UCSD-Quadcopter-Class/quad-hardware-yolo/design_reviews/questions_about_our_board.txt

Meeting Location: NVSL (CSE 2209)
Meeting Time: May 3rd, 7:00pm

 - The vias should go all the way around all the antenna components
