UCSD-Quadcopter-Class/quad-hardware-yolo/quadcopter.dxf

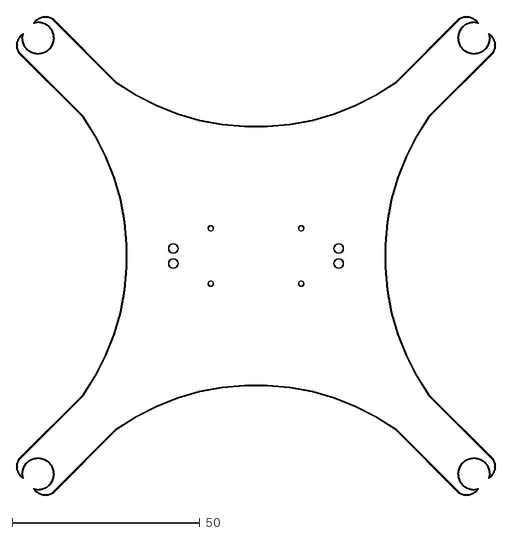
[picture p1: CAD file, 2017-05-15]
quadcopter.dxf
127.6 x 127.6
