UCSD-Quadcopter-Class/quad-hardware-yolo/quadcopter.brd

## EAGLE design quadcopter.brd (2017-05-15)

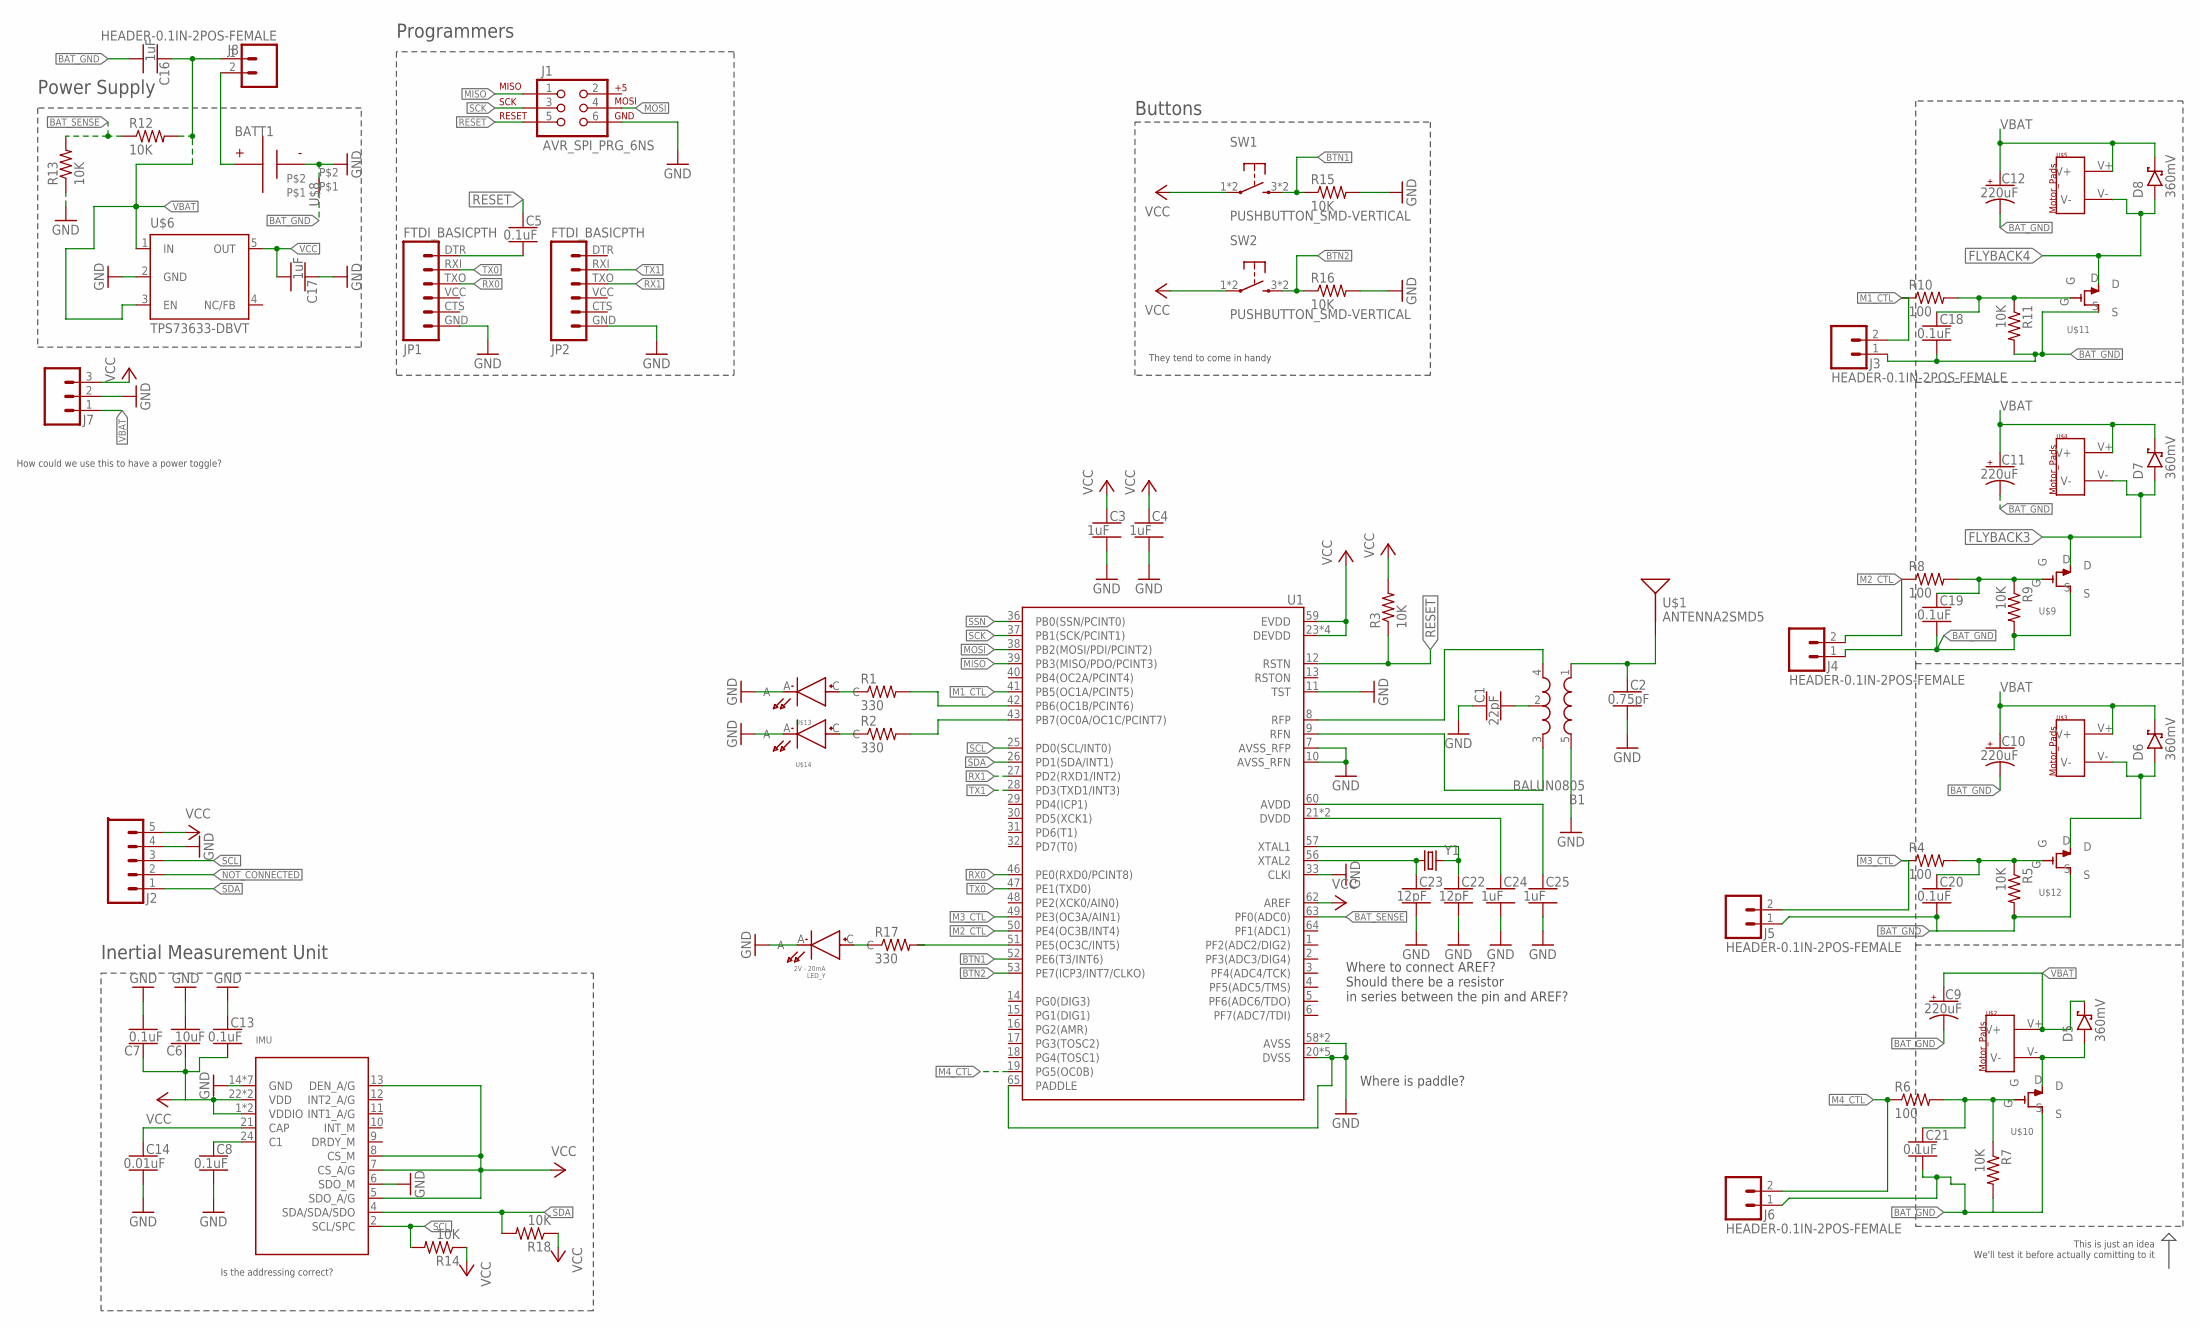
[picture p2: schematic quadcopter.sch]

Parts:
B1: BALUN0805; BALUN
BATT1: BATTERY-HUBSAN-W/HOLDER; BATTERY-W/HOLDER-380MAH-HUBSAN
C1: 22pF; CAPC2012X140_HS
C2: 0.75pF; CAPC2012X140_HS
C3, C4, C16, C17, C24, C25: 1uF; CAPC2012X140_HS
C5, C7, C8, C13, C18, C19, C20, C21: 0.1uF; CAPC2012X140_HS
C6: 10uF; CAPC2012X140_HS
C9, C10, C11, C12: 220uF; CAPMP7343X310_HS
C14: 0.01uF; CAPC2012X140_HS
C22, C23: 12pF; CAPC2012X140_HS
D5, D6, D7, D8: 360mV; SOD3716X135_HS
IMU: IMU; IMU_LSM9DS1TR
J1: AVR_SPI_PRG_6NS; 2X3-NS
J2: HEADER-0.1IN-5POS-FEMALE; HDRV5W63P254_5X1_1270X254H838_HS
J3, J4, J5, J6, J8: HEADER-0.1IN-2POS-FEMALE; HDRV2W63P254_2X1_508X254H838_HS
J7: HEADER-0.1IN-3POS-MALE; HDRV3W63P254_3X1_762X254H838_HS
JP1, JP2: FTDI_BASICPTH; FTDI_BASIC
LED_Y: 2V - 20mA; LED_LTST-C170EKT
R1, R2, R17: 330; RESC2012X60_HS
R3, R5, R7, R9, R11, R12, R13, R14, R15, R16, R18: 10K; RESC2012X60_HS
R4, R6, R8, R10: 100; RESC2012X60_HS
SW1, SW2: PUSHBUTTON_SMD-VERTICAL; TE_FSM8JSMA_HS
U1: ATMEGA128RFA1; QFN-64
U$1: ANTENNA2SMD5; ANTENNA-CHIP5
U$2, U$3, U$4, U$5: MOTOR_PADS
U$6: TPS73633-DBVT; SOT23-DBV
U$8: NET_BRIDGE
U$9, U$10, U$11, U$12: N-FET; N_FET_SI2302CDS-T1-E3CT-ND
U$13, U$14: LED-RED; LED_LTST-C170EKT
Y1: CRYSTAL5X3; CRYSTAL-SMD-5X3

Connections:
ATTENNA: B1.1 (IN), C2.1, U$1.FEED
BAT_GND: C9.2 (-), C10.2 (-), C11.2 (-), C12.2 (-), C16.2, C18.2, C19.2, C20.2, C21.2, J3.1, J4.1, J5.1, J6.1, R5.2, R7.2, R9.2, R11.2, U$8.P$1, U$9.S, U$10.S, U$11.S, U$12.S
BAT_SENSE: R12.1, R13.2, U1.63 (PF0(ADC0))
BTN1: R15.1, SW1.3 (2), SW1.4 (2), U1.52 (PE6(T3/INT6))
BTN2: R16.1, SW2.3 (2), SW2.4 (2), U1.53 (PE7(ICP3/INT7/CLKO))
FLYBACK2: D6.A, U$3.V-, U$12.D
FLYBACK3: D7.A, U$4.V-, U$9.D
FLYBACK4: D8.A, U$5.V-, U$11.D
GND: B1.5 (GND), BATT1.- (N), C1.1, C2.2, C3.2, C4.2, C6.2, C7.2, C8.2, C13.1, C14.2, C17.1, C22.2, C23.2, C24.2, C25.2, IMU.6 (SDO_M), IMU.14 (GND), IMU.15 (GND), IMU.16 (GND), IMU.17 (GND), IMU.18 (GND), IMU.19 (GND), IMU.20 (GND), J1.6, J2.4, J7.2, JP1.GND (6), JP2.GND (6), LED_Y.A, R13.1, R15.2, R16.2, U1.7 (AVSS_RFP), U1.10 (AVSS_RFN), U1.11 (TST), U1.20 (DVSS), U1.24 (DVSS), U1.33 (CLKI), U1.35 (DVSS), U1.45 (DVSS), U1.55 (DVSS), U1.58 (AVSS), U1.61 (AVSS), U1.65 (PADDLE), U$6.2 (GND), U$8.P$2, U$13.A, U$14.A
M1_CTL: J3.2, R10.1, U1.41 (PB5(OC1A/PCINT5))
M2_CTL: J4.2, R8.1, U1.50 (PE4(OC3B/INT4))
M3_CTL: J5.2, R4.1, U1.49 (PE3(OC3A/AIN1))
M4_CTL: J6.2, R6.1, U1.19 (PG5(OC0B))
MISO: J1.1, U1.39 (PB3(MISO/PDO/PCINT3))
MOSI: J1.4, U1.38 (PB2(MOSI/PDI/PCINT2))
unnamed: C5.2, JP1.DTR (1)
unnamed: R2.2, U1.43 (PB7(OC0A/OC1C/PCINT7))
unnamed: B1.2 (GND), C1.2
unnamed: R1.2, U1.42 (PB6(OC1B/PCINT6))
unnamed: R1.1, U$13.C
unnamed: R2.1, U$14.C
unnamed: D5.A, U$2.V-, U$10.D
unnamed: C20.1, R4.2, R5.1, U$12.G
unnamed: C8.1, IMU.24 (C1)
unnamed: BATT1.+, J8.2
unnamed: C19.1, R8.2, R9.1, U$9.G
unnamed: C21.1, R6.2, R7.1, U$10.G
unnamed: C18.1, R10.2, R11.1, U$11.G
unnamed: C14.1, IMU.21 (CAP)
unnamed: C22.1, U1.57 (XTAL1), Y1.3 (2)
unnamed: R17.2, U1.51 (PE5(OC3C/INT5))
unnamed: LED_Y.C, R17.1
unnamed: C23.1, U1.56 (XTAL2), Y1.1
unnamed: C24.1, U1.21 (DVDD), U1.22 (DVDD)
unnamed: C25.1, U1.60 (AVDD)
NOT_CONNECTED: J2.2
RESET: C5.1, J1.5, R3.1, U1.12 (RSTN)
RFN: B1.3 (OUT2), U1.9 (RFN)
RFP: B1.4 (OUT1), U1.8 (RFP)
RX0: JP1.TXO (3), U1.46 (PE0(RXD0/PCINT8))
RX1: JP2.TXO (3), U1.27 (PD2(RXD1/INT2))
SCK: J1.3, U1.37 (PB1(SCK/PCINT1))
SCL: IMU.2 (SCL/SPC), J2.3, R14.2, U1.25 (PD0(SCL/INT0))
SDA: IMU.4 (SDA/SDA/SDO), J2.1, R18.2, U1.26 (PD1(SDA/INT1))
SSN: U1.36 (PB0(SSN/PCINT0))
TX0: JP1.RXI (2), U1.47 (PE1(TXD0))
TX1: JP2.RXI (2), U1.28 (PD3(TXD1/INT3))
VBAT: C9.1 (+), C10.1 (+), C11.1 (+), C12.1 (+), C16.1, D5.C, D6.C, D7.C, D8.C, J7.1, J8.1, R12.2, U$2.V+, U$3.V+, U$4.V+, U$5.V+, U$6.1 (IN), U$6.3 (EN)
VCC: C3.1, C4.1, C6.1, C7.1, C13.2, C17.2, IMU.1 (VDDIO), IMU.3 (VDDIO), IMU.5 (SDO_A/G), IMU.7 (CS_A/G), IMU.8 (CS_M), IMU.13 (DEN_A/G), IMU.22 (VDD), IMU.23 (VDD), J2.5, J7.3, R3.2, R14.1, R18.1, SW1.1, SW1.2 (1), SW2.1, SW2.2 (1), U1.23 (DEVDD), U1.34 (DEVDD), U1.44 (DEVDD), U1.54 (DEVDD), U1.59 (EVDD), U1.62 (AREF), U$6.5 (OUT)

Notes on the sheet:
Where is paddle?
Where to connect AREF? Should there be a resistor in series between the pin and AREF?
Power Supply
Programmers
Inertial Measurement Unit
This is just an idea We'll test it before actually comitting to it
Buttons
They tend to come in handy
Is the addressing correct?
How could we use this to have a power toggle?

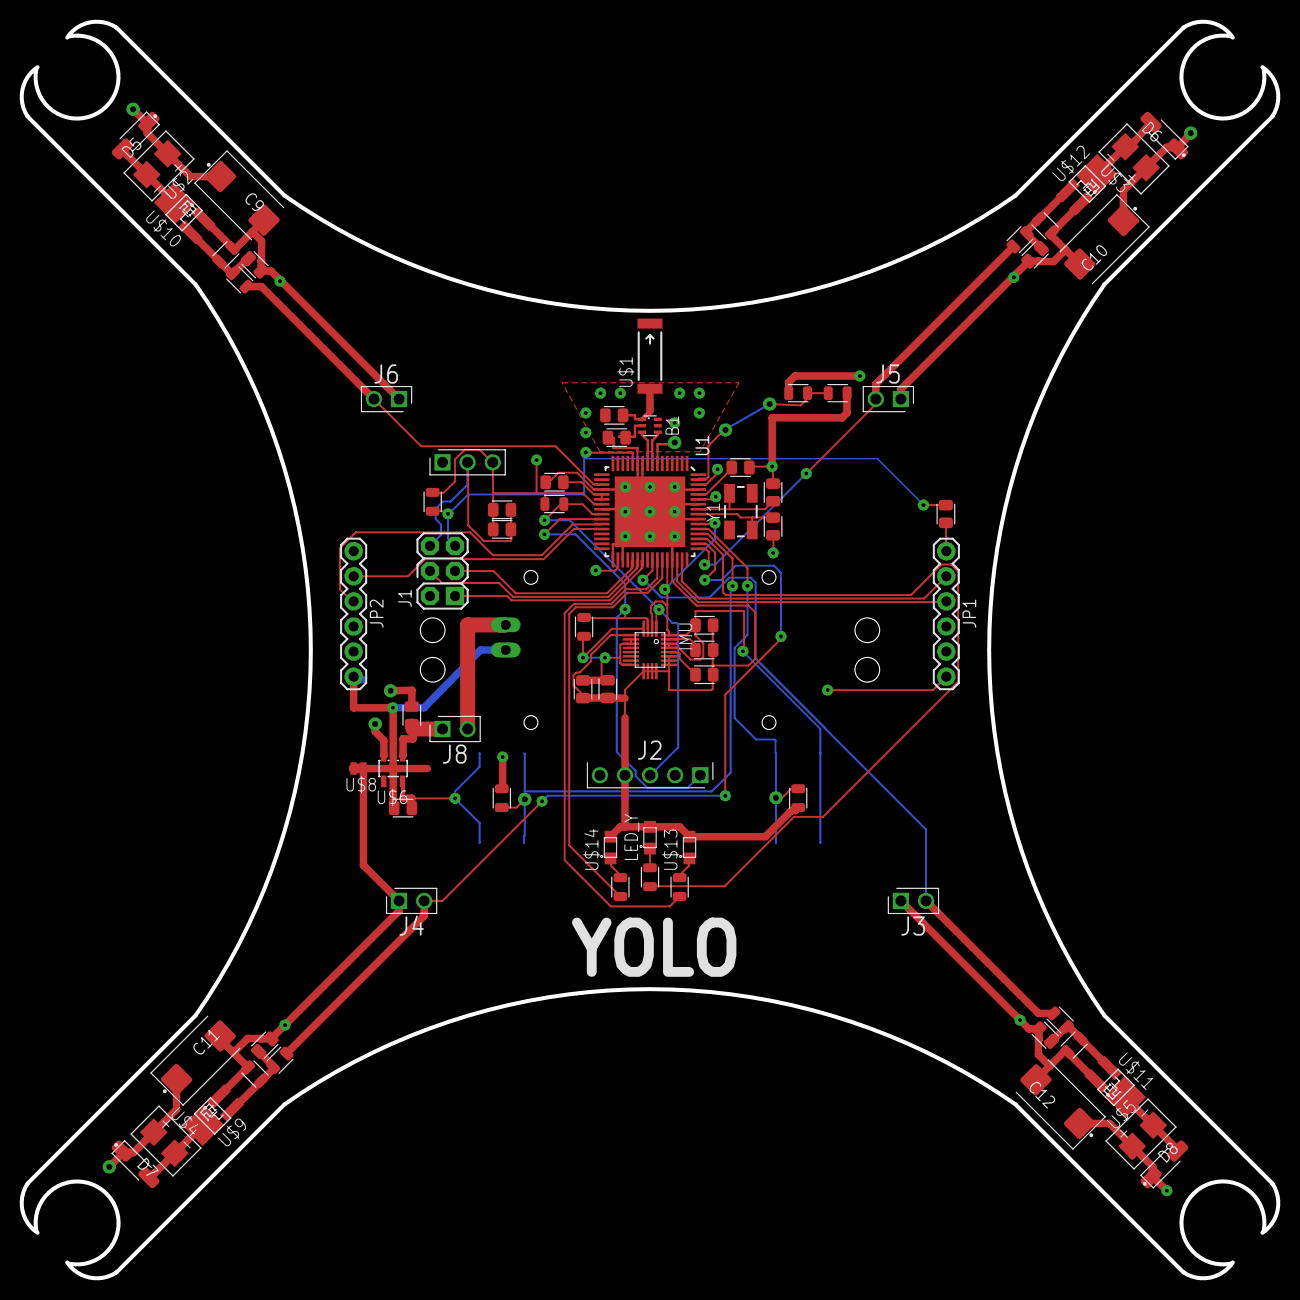
[picture p3: board quadcopter.brd from above]

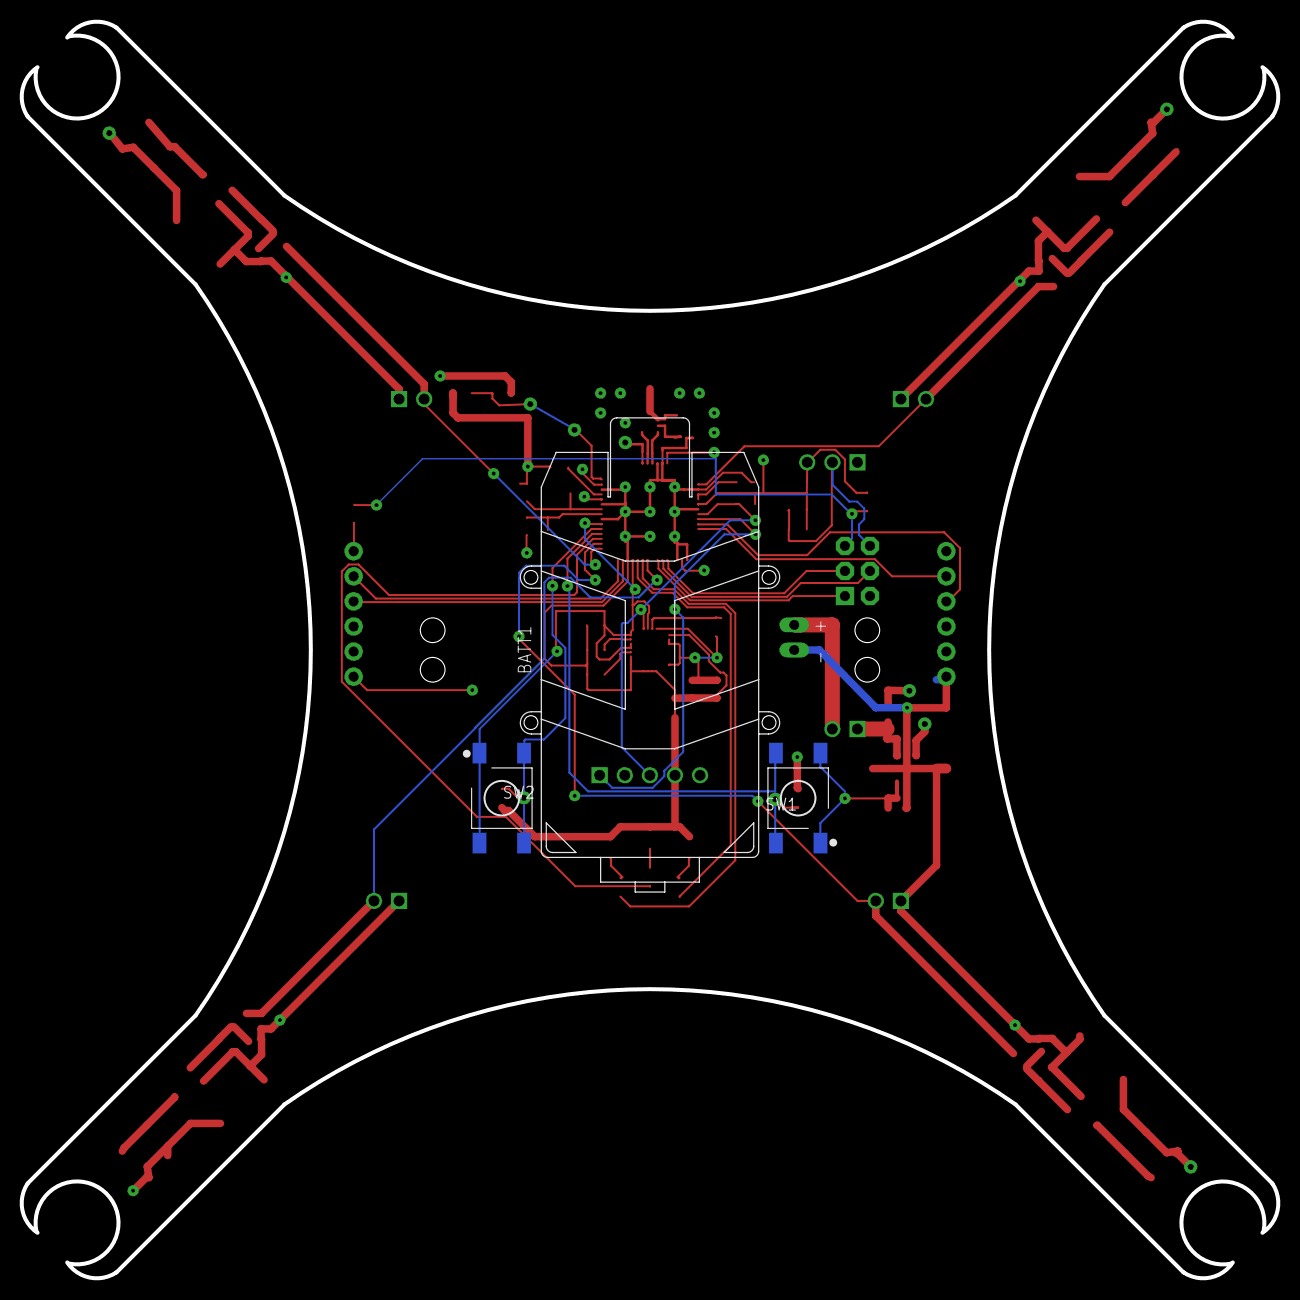
[picture p4: board quadcopter.brd from below]

Board: 4 copper layers, 127.2 x 127.2 mm, 77 parts (3 on the bottom side), 47 nets.
