UCSD-Quadcopter-Class/quad-hardware-yolo/(commit log)

2017-04-18 Starting schematic
    [quadcopter.sch]
2017-04-18 Added motors
    [quadcopter.sch]
2017-04-18 Added voltage regulator and imu
    [quadcopter.sch]
2017-04-18 mostly finished
    [quadcopter.sch]
2017-04-20 Many updates
    [quadcopter.sch]
2017-04-20 Fixed IMU pin mappings
    [quadcopter.sch]
2017-04-20 Using LEDs from previous lab
    [quadcopter.sch]
2017-04-20 passing eagle lint
    [quadcopter.sch]
2017-04-24 updated motor schematic
    [quadcopter.sch]
2017-04-24 removed gadgetron grounds
    [quadcopter.sch]
2017-04-25 Fixed spacing issue and reset issue
    [quadcopter.sch]
2017-04-25 started board
    [quadcopter.brd, quadcopter.sch]
2017-04-26 started laying out basic board
    [quadcopter.brd, quadcopter.sch]
2017-04-26 basic board layout added
    [quadcopter.brd, quadcopter.sch]
2017-04-26 made board more curvy
    [quadcopter.brd, quadcopter.sch]
2017-04-26 board updates
    [quadcopter.brd]
2017-04-26 fancy layout
    [quadcopter.brd]
2017-04-27 instructior review of original schematic
2017-04-28 made motor drivers all neat, tried to organize rest of components more neatly as well
    [quadcopter.brd]
2017-05-01 laid components more nicely
    [quadcopter.brd]
2017-05-01 Did some really careful math for placing prop grips
    [quadcopter.brd]
2017-05-01 Fixed n-fet and imu packages
    [quadcopter.brd, quadcopter.sch]
2017-05-01 routed radio
    [quadcopter.brd]
2017-05-01 added i2c pullups, placed oscillator components
    [quadcopter.brd, quadcopter.sch]
2017-05-01 layed down bat plane
    [quadcopter.brd, quadcopter.sch]
2017-05-01 Layed out power planes
    [quadcopter.brd, quadcopter.sch]
2017-05-02 found a much better way to layout pours
    [quadcopter.brd]
2017-05-02 further isolated attenna
    [quadcopter.brd, quadcopter.sch]
2017-05-02 swaped motor 2 and 4
    [quadcopter.brd, quadcopter.sch]
2017-05-02 passing parts of drc
    [quadcopter.brd, quadcopter.sch]
2017-05-02 Made tkeepouts stricter on imu, laid out components out nicer
    [quadcopter.brd, quadcopter.sch]
2017-05-04 Added board reviews
2017-05-04 initial cam, has 2 missing soldermask clearance violations, one for netbridge which is ok, and other for vias that consist of the faraday cage
2017-05-08 Made cutout in pour for imu
    [quadcopter.brd]
2017-05-08 fixed pwm filters
    [quadcopter.brd, quadcopter.sch]
2017-05-08 Manually routed motors
    [quadcopter.brd, quadcopter.sch]
2017-05-08 More manual routing
    [quadcopter.brd]
2017-05-08 too much manual routing
    [quadcopter.brd]
2017-05-11 manually routed a lot of traces from the microcontroller and imu to make autorouter run significantly better, also symetrically laid out the motors and motor pins. cam files appear to have passed fre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
    [quadcopter.brd]
2017-05-11 updated some of the traces to make them nicer, also rerouted autorouted trace that went under imu
    [quadcopter.brd]
2017-05-11 final touches on internal routes, everything still passes cam, looks ready for review
    [quadcopter.brd, quadcopter.sch]
2017-05-11 added documentation on netbridge DFM potential show stopper
    [quadcopter.brd]
2017-05-11 Approving stopmask bugs
    [quadcopter.brd]
2017-05-11 approved more restrict errors for antenna components
    [quadcopter.brd]
2017-05-11 moved bottom trace out of restrict area for IMU
    [quadcopter.brd]
2017-05-11 spaced vias to right of microcontroller further apart, also noticed vias in faraday cage are close together
    [quadcopter.brd]
2017-05-11 moved and resized a few vias
    [quadcopter.brd]
2017-05-11 fixed small hole near net bridge
    [quadcopter.brd]
2017-05-12 positioned crystal better, need to reroute a couple traces
    [quadcopter.brd]
2017-05-12 oscillator complete, traces rerouted and added more ground vias to reduce surface grounds
    [quadcopter.brd]
2017-05-12 more ground connections
    [quadcopter.brd]
2017-05-12 updated imu package to make pads smaller, no more clearance issues with that now
2017-05-12 started to fix attenna pours
    [quadcopter.brd]
2017-05-12 updated imu on board, rerouted some dangerous looking wires, approved drc
    [quadcopter.brd, quadcopter.sch]
2017-05-12 minor updates
    [quadcopter.brd]
2017-05-14 fixed attenna
    [quadcopter.brd]
2017-05-14 changed caps, moving grounds
    [quadcopter.brd, quadcopter.sch]
2017-05-15 remapped and rewired M2_CTL and M3_CTL since the pins they were on were not originally PWM pins
    [quadcopter.brd, quadcopter.sch]
2017-05-15 dunno what i just did
    [quadcopter.brd]
2017-05-15 fixed diode pads
2017-05-15 added updated flybacks to board
    [quadcopter.brd, quadcopter.sch]
2017-05-15 renaming parts
    [quadcopter.brd, quadcopter.sch]
2017-05-15 made farady cage tighter, added heat sink
    [quadcopter.brd]
2017-05-15 More gnd cleaning
    [quadcopter.brd, quadcopter.sch]
2017-05-15 fixed loop near netbridge, added yolo to board, moved caps
    [quadcopter.brd]
